iwaynee/Wireless_DMX/README.md

# <b>Wireless_DMX</b>

This is the Documentation of the Project Wirless_DMX.
Unfortunatly I had to do the Documentation in German. But the Code is fully commented in English.

wireless_dmx

<b>Short description:</b>
- Wireless <b>DMX512</b> Signal
- Material Cost ca. 35-40 CHF = <b>36 EUR</b>
- Line-of-sight send Distanz: <b>ca. 350m</b>
- <b>nRF24L01+PA+LNA</b> MODULE
- Adressable Transmitter/Receiver
- State LED

<b>PCB:</b><br>
The PCB Layout is available in Mentor Graphics or as raw Gerber Data. Please Message me for more Informations.

<b>Code:</b><br>
You will need to whole folder "Librarys" and one of the folder Transmitter/Receiver to get it working.

The files are finished Atmel Studio 7.0 projects and the source code is written in C.
