iwaynee/Wireless_DMX/PCB/Bestellliste.xlsx

Bestelliste: Wireless_DMx
 | Alle Bauteile: |  |  |  |  |  |  |  | Noch Bestellen |  | 10 | Prints
 |  |  |  |  |  | Fuer 1 Print
 | Name | Refrence | Bestell-Nr | Verkäufer | Form | Anzahl | Kosten pro Stück | Kosten pro Print | Vorhanden | Restliche | Mindest Bestellmenge | Restliche Kosten für x Prints
 | ATMEGA32u4 | IC4 | 2443182 | Farnell | SMD | 1 | Fr.6.669 | Fr.6.67 | 0 | 10 | 10 | Fr.66.69
 | DIP-switch 8pol | S1 | 2435170 | Farnell | THT | 1 | Fr.0.930 | Fr.0.93 | 0 | 10 | 10 | Fr.9.30
 | SN75176BDR | IC5 | 2395904 | Farnell | SMD | 1 | Fr.0.708 | Fr.0.71 | 0 | 10 | 1 | Fr.7.08
 | TXC 16MHZ Quarz | Q1 | 1841946 | Farnell | SMD | 1 | Fr.0.920 | Fr.0.92 | 0 | 10 | 1 | Fr.9.20
 | TLV1117-33CDCY 3.3V Regulator | IC1 | 1436339 | Farnell | SMD | 1 | Fr.0.490 | Fr.0.49 | 0 | 10 | 1 | Fr.4.90
 | Kondensator 18pF | C7, C8 | 1759194 | Farnell | SMD | 2 | Fr.0.021 | Fr.0.04 | 0 | 20 | 10 | Fr.0.41
 | Widerstand 220 Ohm | R2, R3 | 1099795 | Farnell | SMD | 2 | Fr.0.026 | Fr.0.05 | 0 | 20 | 10 | Fr.0.52
 | Kondensator 100nF | C1, C2, C9 | 1740673 | Farnell | SMD | 4 | Fr.0.038 | Fr.0.15 | 0 | 40 | 10 | Fr.1.54
 | Widerstand 560 Ohm | R6 | 1100185 | Farnell | SMD | 1 | Fr.0.020 | Fr.0.02 | 0 | 10 | 10 | Fr.0.20
 | Widerstand 4.7 KOhm | R4, R5 | 1099805 | Farnell | SMD | 2 | Fr.0.020 | Fr.0.04 | 0 | 20 | 10 | Fr.0.39
 | Kondensator 10nF | C4, C5 | 499225 | Farnell | SMD | 2 | Fr.0.022 | Fr.0.04 | 0 | 20 | 10 | Fr.0.45
 | Kondensator 330nF | C3 | 2497099 | Farnell | SMD | 1 | Fr.0.182 | Fr.0.18 | 0 | 10 | 5 | Fr.1.82
 | Widerstand 47 KOhm | R1 | 1099812 | Farnell | SMD | 1 | Fr.0.026 | Fr.0.03 | 0 | 10 | 10 | Fr.0.26
 | UA78M05IDCY 5V Regulator | IC2 | 1494947 | Farnell | SMD | 1 | Fr.0.322 | Fr.0.32 | 0 | 10 | 10 | Fr.3.22
 | Steckverbindergehäuse, 2 -polig |  | 143126 | Farnell |  | 1 | Fr.0.179 | Fr.0.18 | 0 | 10 | 10 | Fr.1.79
 | Steckverbindergehäuse, 3 -polig |  | 143127 | Farnell |  | 1 | Fr.0.210 | Fr.0.21 | 0 | 10 | 10 | Fr.2.10
 | Steckverbinder, 2 -polig | J2, J3, J4 | 1462926 | Farnell | THT | 1 | Fr.0.066 | Fr.0.07 | 0 | 10 | 1 | Fr.0.66
 | Steckverbinder, 3 -polig | J1 | 1462950 | Farnell | THT | 1 | Fr.0.114 | Fr.0.11 | 0 | 10 | 1 | Fr.1.14
 | PCB (Pauschale) |  | - | EasyEDA |  | 1 | Fr.5.000 | Fr.5.00 | 0 | 10 | - | Fr.50.00
 | 9V Netzteil 5W |  | 2451860 | Farnell |  | 1 | Fr.8.930 | Fr.8.93 | 0 | 10 | 5 | Fr.89.30
 | Gehäuse |  | 2393701 | Farnell |  | 1 | Fr.1.500 | Fr.1.50 | 0 | 10 | 10 | Fr.15.00
 | DC-Buchse |  | 1216726 | Farnell |  | 1 | Fr.1.150 | Fr.1.15 | 0 | 10 | 10 | Fr.11.50
 | NRF24L01+ Amp | IC3 | 1066640 | Banggood | THT | 1 | Fr.3.200 | Fr.3.20 | 0 | 10 | 1 | Fr.32.00
 | DMX Buchse (Pauschale) |  | - | Conrad |  | 1 | Fr.2.000 | Fr.2.00 | 0 | 10 | 1 | Fr.20.00
 | LED Grün/Rot |  |  |  | THT | 2 | Fr.0.250 | Fr.0.50 |  | 20 | 1 | Fr.5.00
 | Total: |  |  |  |  |  |  | Fr.33.45 |  |  |  | Fr.334.47
 |  |  |  |  | GEOMETRY | DESCRI | REFERENCE NAME
 |  |  |  |  | so0805 |  | C1
 |  |  |  |  | so0805 |  | C2
 |  |  |  |  | so1206 |  | C3
 |  |  |  |  | so0805 |  | C4
 |  |  |  |  | so0805 |  | C5
 |  |  |  |  | so0805 |  | C7
 |  |  |  |  | so0805 |  | C8
 |  |  |  |  | so0805 |  | C9
 |  |  |  |  | SOT223 |  | IC1
 |  |  |  |  | SOT223 |  | IC2
 |  |  |  |  | nrf24l01+_amp |  | IC3
 |  |  |  |  | tqfp44 |  | IC4
 |  |  |  |  | soic8 |  | IC5
 |  |  |  |  | mx6410_3g |  | J1
 |  |  |  |  | mx6410_2g |  | J2
 |  |  |  |  | mx6410_2g |  | J3
 |  |  |  |  | mx6410_2g |  | J4
 |  |  |  |  | conn_2x5_2.54 |  | J5
 |  |  |  |  | smd_quarz_2pad | 16MHz | Q1
 |  |  |  |  | so0805 |  | R1
 |  |  |  |  | so0805 |  | R2
 |  |  |  |  | so0805 |  | R3
 |  |  |  |  | so0805 |  | R4
 |  |  |  |  | so0805 |  | R5
 |  |  |  |  | so1206 |  | R6
 |  |  |  |  | dipswitch_4x |  | S1
